mgesteiro/mylamp/docs/schematic-pins.jpg

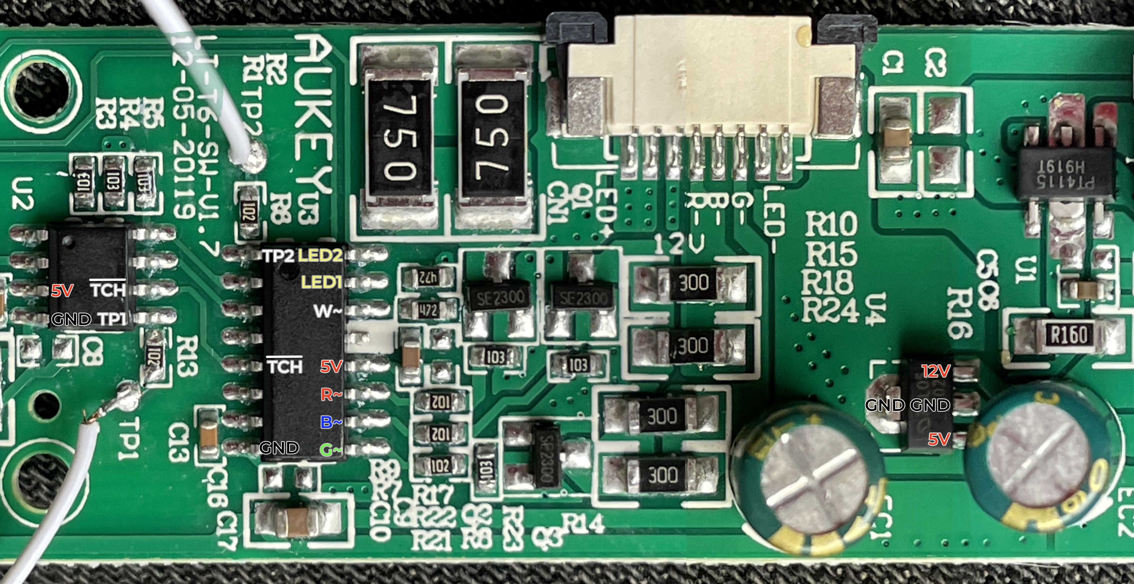
docs/schematic-pins.jpg
